JohnLundy/coleco_adam_usb_keyboard/media/20230817_110905.jpg

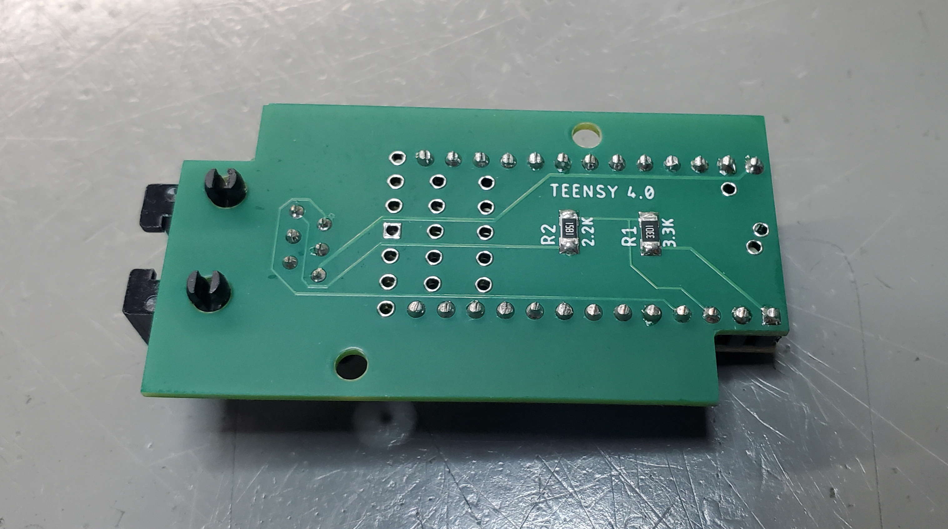
media/20230817_110905.jpg
