JohnLundy/coleco_adam_usb_keyboard/(commit log)

2023-08-02 Delete attached_close.jpg
    Removed
2023-08-02 Delete attached_close_sm.jpg
    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
2023-08-02 Added schematic
2023-08-02 Update README.md
    Added schematic
2023-08-17 Added PCB Gerbers and BOM
    Added PCB Gerbers and BOM
2023-08-17 Added populated PCB build pictures
    Added populated PCB build pictures
2023-08-17 Added top side PCB - small
    Added top side PCB - small
